kutukvpavel/LabPID/misc/pid coeff.PNG

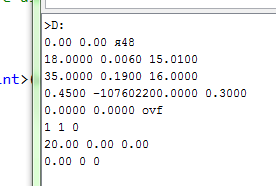
misc/pid coeff.PNG
