kutukvpavel/LabPID/pcb/pid.jpg

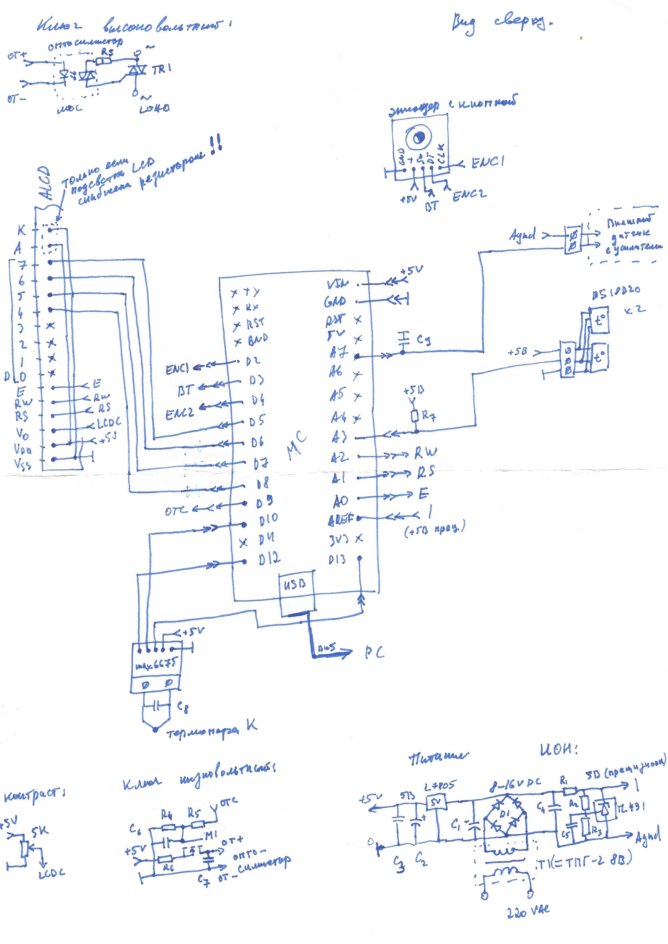
pcb/pid.jpg
