kutukvpavel/LabPID/(list of files, drawings)

Other design files:
pcb/1.lay6
pcb/new/PID.pdsprj
