kutukvpavel/LabPID/Firmware-vscode/src/PCA9555-master/clsPCA9555.cpp

/**
 * @file    clsPCA9555.cpp
 * @author     Nico Verduin
 * @date      9-8-2015
 *
 * @mainpage  clsPCA9555
 * Class to enable pinMode(), digitalRead() and digitalWrite() functions on PCA9555 IO expanders
 *
 * Additional input received from Rob Tillaart (9-8-2015)
 *
 * @par License info
 *
 * Class to enable the use of single pins on PCA9555 IO Expander using
 * pinMode(), digitalRead() and digitalWrite().
 *
 * Copyright (C) 2015  Nico Verduin
 *
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
 */

#if defined(ARDUINO) && ARDUINO >= 100
#include "Arduino.h"
#else
#include "WProgram.h"
#endif

#include "clsPCA9555.h"
#include "Wire.h"

//PCA9555* PCA9555::instancePointer = 0;

/**
 * @name PCA9555 constructor
 * @param address I2C address of the IO Expander
 * Creates the class interface and sets the I2C Address of the port
 */
PCA9555::PCA9555(uint8_t address/*, int interruptPin*/) {
    _address         = address;        // save the address id
    _valueRegister   = 0xFFFFu;
    Wire.begin();                      // start I2C communication

    /*if(interruptPin >= 0)
    {
    instancePointer = this;
    attachInterrupt(digitalPinToInterrupt(interruptPin), PCA9555::alertISR, LOW); // Set to low for button presses
    }*/
}

// Checks if PCA9555 is responsive. Refer to Wire.endTransmission() from Arduino for details.
bool PCA9555::begin(){
    Wire.beginTransmission(_address);
    Wire.write(0x02); // Test Address
    _error = Wire.endTransmission();

    if(_error != 0){
      return false;
    }else{

      return true;
    }
}

/**
 * @name pinMode
 * @param pin       pin number
 * @param IOMode    mode of pin INPUT or OUTPUT
 * sets the mode of this IO pin
 */
void PCA9555::pinMode(uint8_t pin, uint8_t IOMode) {

    //
    // check if valid pin first
    //
    if (pin <= 15) {
        //
        // now set the correct bit in the configuration register
        //
        if (IOMode == OUTPUT) {
            //
            // mask correct bit to 0 by inverting x so that only
            // the correct bit is LOW. The rest stays HIGH
            //
            _configurationRegister = _configurationRegister & ~(1 << pin);
        } else {
            //
            // or just the required bit to 1
            //
            _configurationRegister = _configurationRegister | (1 << pin);
        }
        //
        // write configuration register to chip
        //
        I2CSetValue(_address, NXP_CONFIG    , _configurationRegister_low);
        I2CSetValue(_address, NXP_CONFIG + 1, _configurationRegister_high);
    }
}
/**
 * @name digitalRead Reads the high/low value of specified pin
 * @param pin
 * @return value of pin
 * Reads the selected pin.
 */
uint8_t PCA9555::digitalRead(uint8_t pin) {
    //
    // we wil only process pins <= 15
    //
    if (pin > 15) return 255;
    uint16_t _inputData = readAll();
    //
    // now mask the bit required and see if it is a HIGH
    //
    if ((_inputData & (1 << pin)) > 0){
        //
        // the bit is HIGH otherwise we would return a LOW value
        //
        return HIGH;
    } else {
        return LOW;
    }
}

/**
 * @brief Returns 
 * 
 * @return uint8_t 
 */
uint16_t PCA9555::readAll()
{
    uint16_t _inputData = 0;
    _inputData  = I2CGetValue(_address, NXP_INPUT);
    _inputData |= I2CGetValue(_address, NXP_INPUT + 1) << 8;
    return _inputData;
}

void PCA9555::writeAll(uint16_t state)
{
    _valueRegister = state;
    I2CSetValue(_address, NXP_OUTPUT    , _valueRegister_low);
    I2CSetValue(_address, NXP_OUTPUT + 1, _valueRegister_high);
}

uint16_t PCA9555::getOutputRegister()
{
    return _valueRegister;
}

void PCA9555::digitalWrite(uint8_t pin, uint8_t value) {
    //
    // check valid pin first
    //
    if (pin > 15 ){
        _error = 255;            // invalid pin
        return;                  // exit
    }
    //
    // if the value is LOW we will and the register value with correct bit set to zero
    // if the value is HIGH we will or the register value with correct bit set to HIGH
    //
    if (value > 0) {
        //
        // this is a High value so we will or it with the value register
        //
        _valueRegister = _valueRegister | (1 << pin);    // and OR bit in register
    } else {
        //
        // this is a LOW value so we have to AND it with 0 into the _valueRegister
        //
        _valueRegister = _valueRegister & ~(1 << pin);    // AND all bits
    }
    writeAll(_valueRegister);
}

// This is the actual ISR
// Stores states of all pins in _stateOfPins
/*void PCA9555::pinStates(){
  _stateOfPins = I2CGetValue(_address, NXP_INPUT);
  _stateOfPins|= I2CGetValue(_address, NXP_INPUT + 1) << 8;
}*/

// Returns to user the state of desired pin
/*uint8_t PCA9555::stateOfPin(uint8_t pin){
  if ((_stateOfPins & (1 << pin)) > 0){
    //
    // the bit is HIGH otherwise we would return a LOW value
    //
    return HIGH;
  } else {
    return LOW;
  }
}*/

/**
 * @name setClock modifies the clock frequency for I2C communication
 * @param clockFrequency
 * clockFrequency: the value (in Hertz) of desired communication clock.
 * The PCA9555 supports a 400kHz clock.
 * Accepted values are:
 *    10000 low speed mode, supported on some processors
 *    100000, standard mode
 *    400000, fast mode
 */
void PCA9555::setClock(uint32_t clockFrequency){
  Wire.setClock(clockFrequency);
}

/*void PCA9555::alertISR()
{
  if (instancePointer != 0)
  {
    instancePointer->pinStates(); // Points to the actual ISR
  }
}*/

//
// low level hardware methods
//

/**
 * @name I2CGetValue
 * @param address Address of I2C chip
 * @param reg    Register to read from
 * @return data in register
 * Reads the data from addressed chip at selected register. \n
 * If the value is above 255, an error is set. \n
 * error codes : \n
 * 256 = either 0 or more than one byte is received from the chip
 */
uint16_t PCA9555::I2CGetValue(uint8_t address, uint8_t reg) {
    uint16_t _inputData;
    //
    // read the address input register
    //
    Wire.beginTransmission(address);          // setup read registers
    Wire.write(reg);
    _error = Wire.endTransmission();
    //
    // ask for 2 bytes to be returned
    //
    if (Wire.requestFrom((int)address, 1) != 1)
    {
        //
        // we are not receing the bytes we need
        //
        return 256;                            // error code is above normal data range
    };
    //
    // read both bytes
    //
    _inputData = Wire.read();
    return _inputData;
}

/**
 * @name I2CSetValue(uint8_t address, uint8_t reg, uint8_t value)
 * @param address Address of I2C chip
 * @param reg    register to write to
 * @param value    value to write to register
 * Write the value given to the register set to selected chip.
 */
void PCA9555::I2CSetValue(uint8_t address, uint8_t reg, uint8_t value){
    //
    // write output register to chip
    //
    Wire.beginTransmission(address);              // setup direction registers
    Wire.write(reg);                              // pointer to configuration register address 0
    Wire.write(value);                            // write config register low byte
    _error = Wire.endTransmission();
}
