kutukvpavel/LabPID/(commit log)

2020-05-05 Добавьте GITIGNORE- и GITATTRIBUTES-файлы.
2020-05-05 Добавьте файлы проекта.
    [1.lay6, pid-regulation.xlsx]
2020-05-05 Cleanup the solution for publication
    [pid-regulation.xlsx]
2020-10-09 Refactoring bugs fixed, custom commands for temperature profiles added.
2021-01-16 Split firmware sources into multiple files, corrected firmware case convention for functions, reduced number of global vars.
    [commands.cpp, display.cpp, mem.cpp, onewire.cpp, thermo.h, thermo.ino]
2021-01-16 Continue to cleanup firmware project, prepare to switch from vsmicro to vscode.
2021-01-16 Got rid of unnecessary libraries (switched to native timers implementation and removed malloc from averaging lib). Removed library examples.
2021-01-16 Added cooling feature (simple binary output to turn on a fan or smth).
2021-04-05 Forgot to stage changes for last commit.
    [PID.pdsprj]
2021-04-30 Testing for v2 started (application boots, the loop is running).
    [PID.pdsprj]
2021-04-30 Fixed bugs for v2. SPI mode seems to be stable. TODO: test with software.
    [commands.cpp, globals.cpp, mem.cpp, onewire.cpp, thermo.h, thermo.ino]
2021-04-30 Software interaction for v2 tested and fixed. Stable (for SPI thermocouple mode, at least).
    [commands.cpp, globals.cpp, thermo.h, thermo.ino]
2021-05-04 GPIO implementation tested and fixed. Enabled negative PID control (for coolers). TODO: test profile system.
    [ClickEncoder.cpp, clsPCA9555.cpp, clsPCA9555.h, commands.cpp, display.cpp, globals.cpp, gpio.cpp, thermo.h]
2021-05-05 Fixed onewire communication (it was set to synchronous), removed associated display workarounds.
    [display.cpp, onewire.cpp, thermo.ino]
2021-05-05 Fixed custom commands for temperature profiles. Also now last loaded profile is loaded automatically.
2021-05-24 Fixed GPIO outputs inadvertent activation during bootup.
    [gpio.cpp, mem.cpp, thermo.h]
2021-06-04 Fixed empty log files issue, adjusted minimum window width, fixed window state not being saved. Also fixed and tested temperature profiles.
2021-07-28 Fixed temperature profile incremental time syntax. It's now uniform across setpoint and custom commands.
2021-09-09 Fix a long standing log issue. Now log files are created only onxe there's something to log and exception logging bypasses log Enabled switch.
2025-03-19 Chage paths to unix Fix UFT-8 BOM in MyFunctions Update CPP intellisense settings
    [DallasTemperature.h, Firmware-vscode.ino, MyFunctions.h, gpio.cpp, onewire.cpp, thermo.h]
2025-03-20 Fix "flaky" encoder algorithm Fix PID intergrator reset logic
    [ClickEncoder.cpp, ClickEncoder.h]
