kutukvpavel/LabPID/(notices)

Notices in the files:
Firmware-vscode/src/PCA9555-master/clsPCA9555.cpp:
This program is free software: you can redistribute it and/or modify
it under the terms of the GNU General Public License as published by
the Free Software Foundation, either version 3 of the License, or
(at your option) any later version.
Program : clsPCA9555 Copyright (C) 2015 Nico Verduin
